jozefcipa/laundry-alert/assets/app-error.png

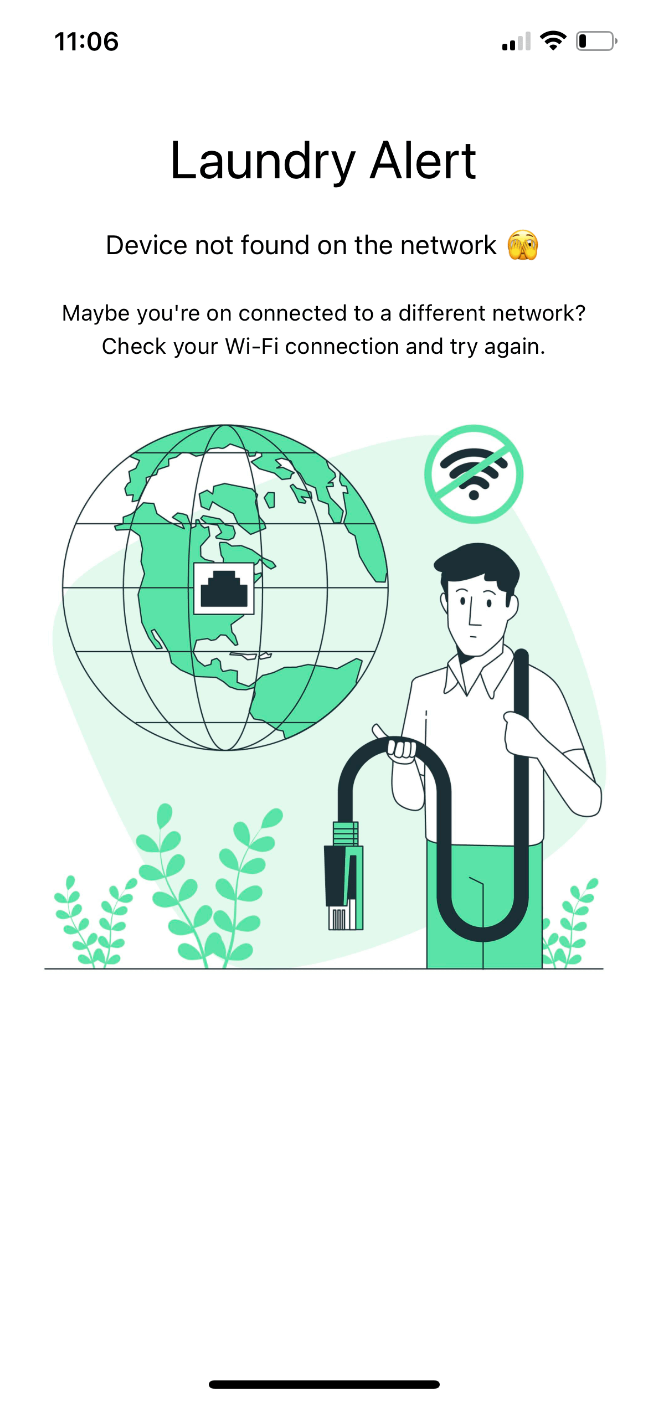
assets/app-error.png
