jozefcipa/laundry-alert/assets/app-loading.png

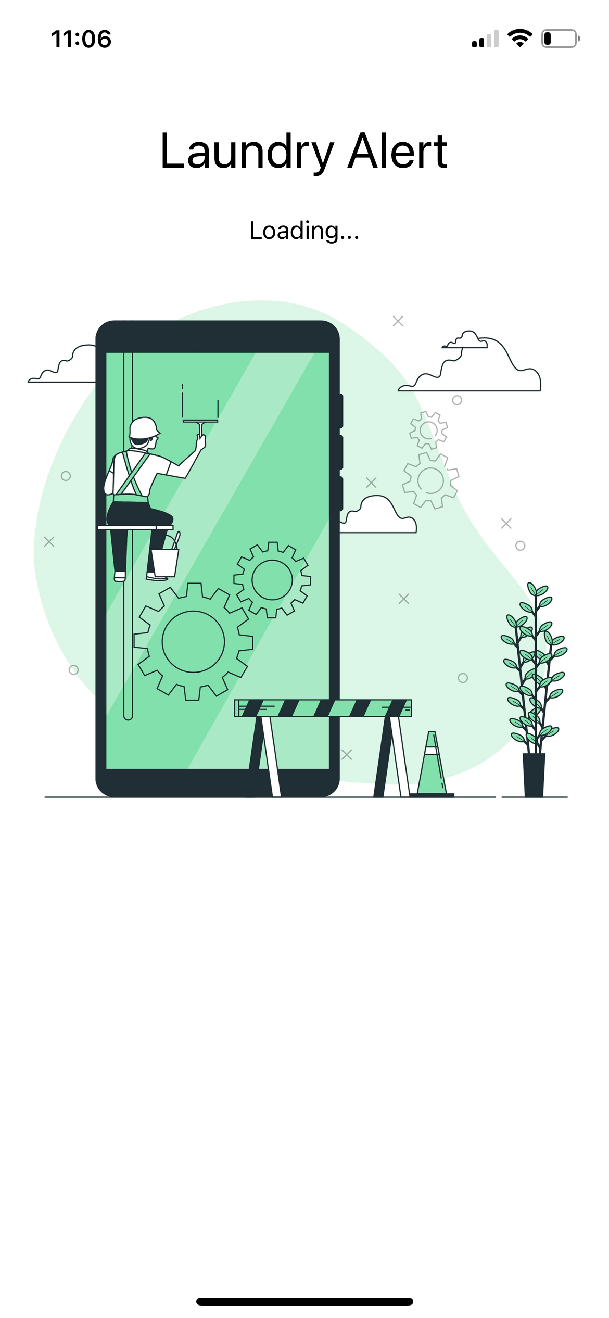
assets/app-loading.png
