jozefcipa/laundry-alert/assets/app-notification.png

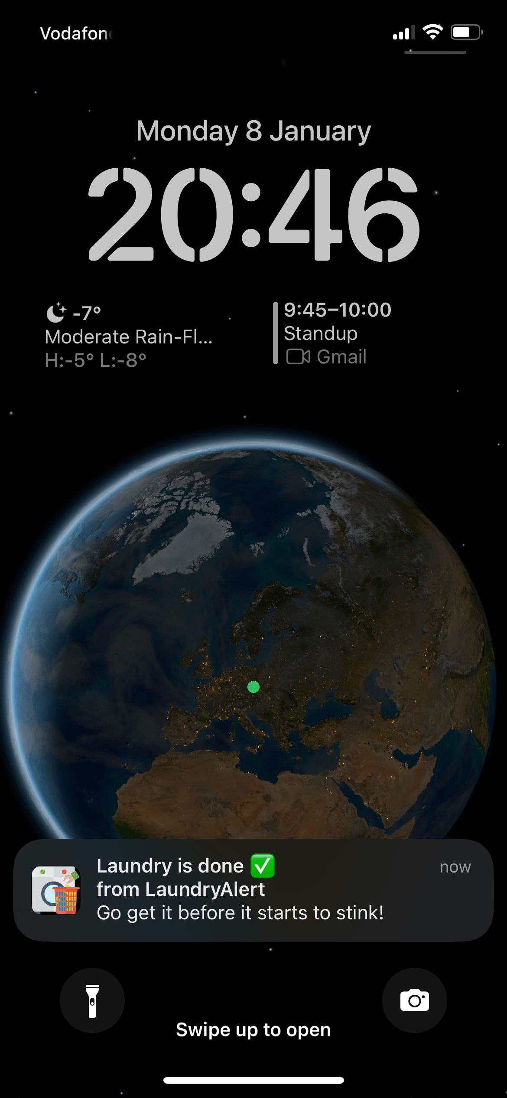
assets/app-notification.png
