jozefcipa/laundry-alert/assets/app-washing-done.png

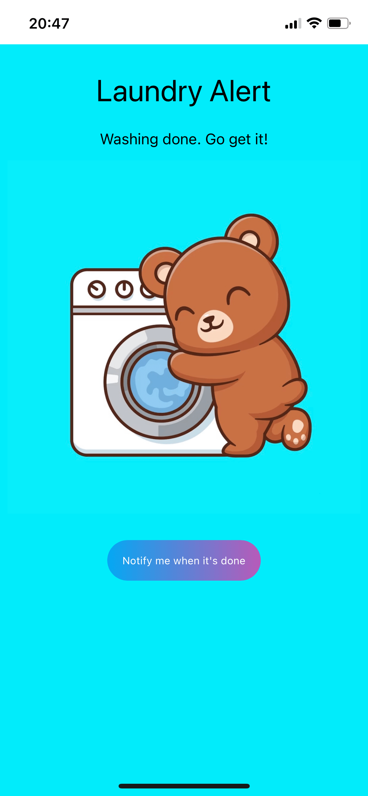
assets/app-washing-done.png
