jozefcipa/laundry-alert/assets/app-washing.png

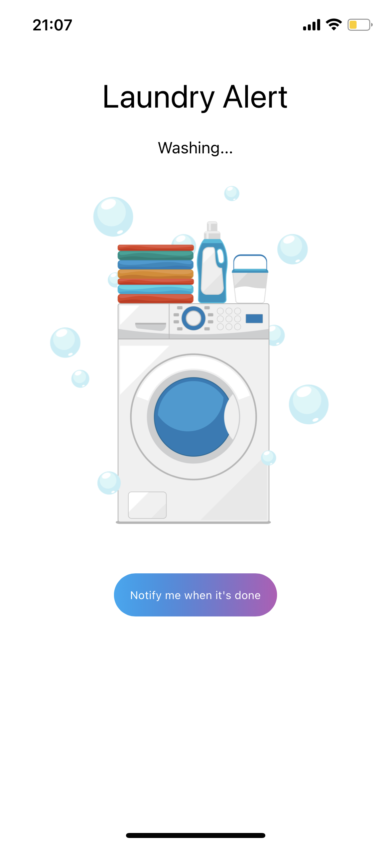
assets/app-washing.png
