jozefcipa/laundry-alert/assets/case.jpeg

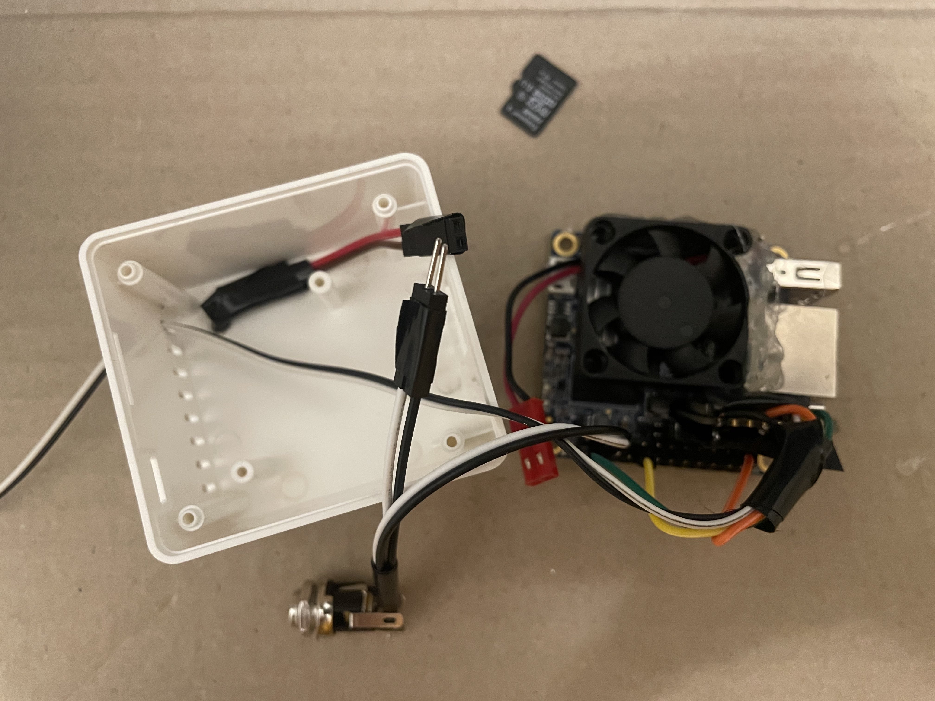
assets/case.jpeg
