jozefcipa/laundry-alert/assets/in-progres.jpeg

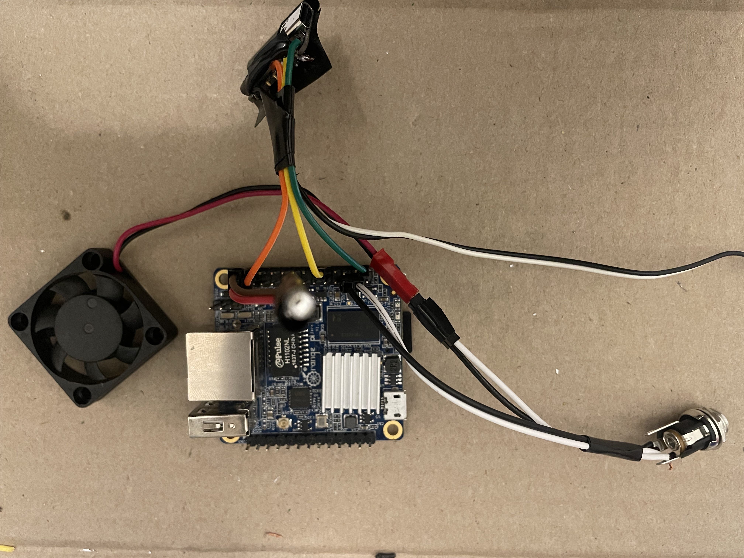
assets/in-progres.jpeg
