jozefcipa/laundry-alert/assets/laundry-alert.jpeg

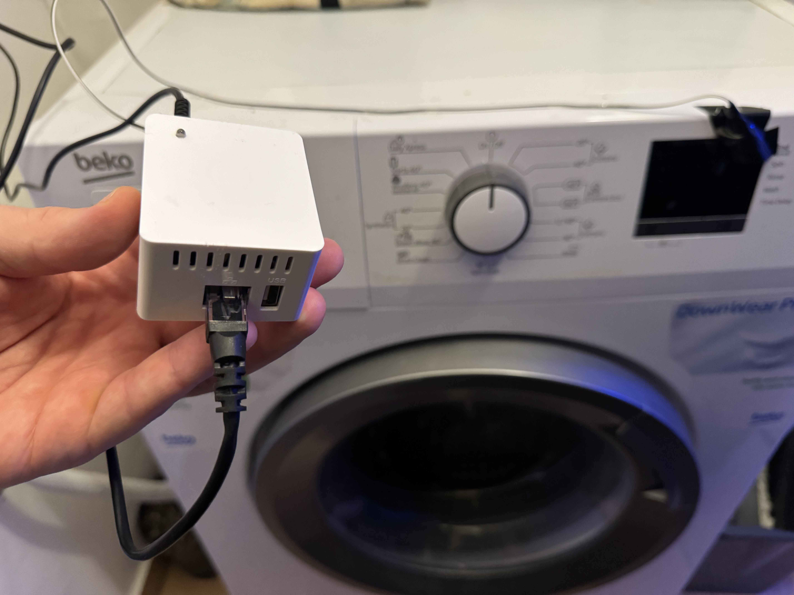
assets/laundry-alert.jpeg
