jozefcipa/laundry-alert/assets/debugging.jpeg

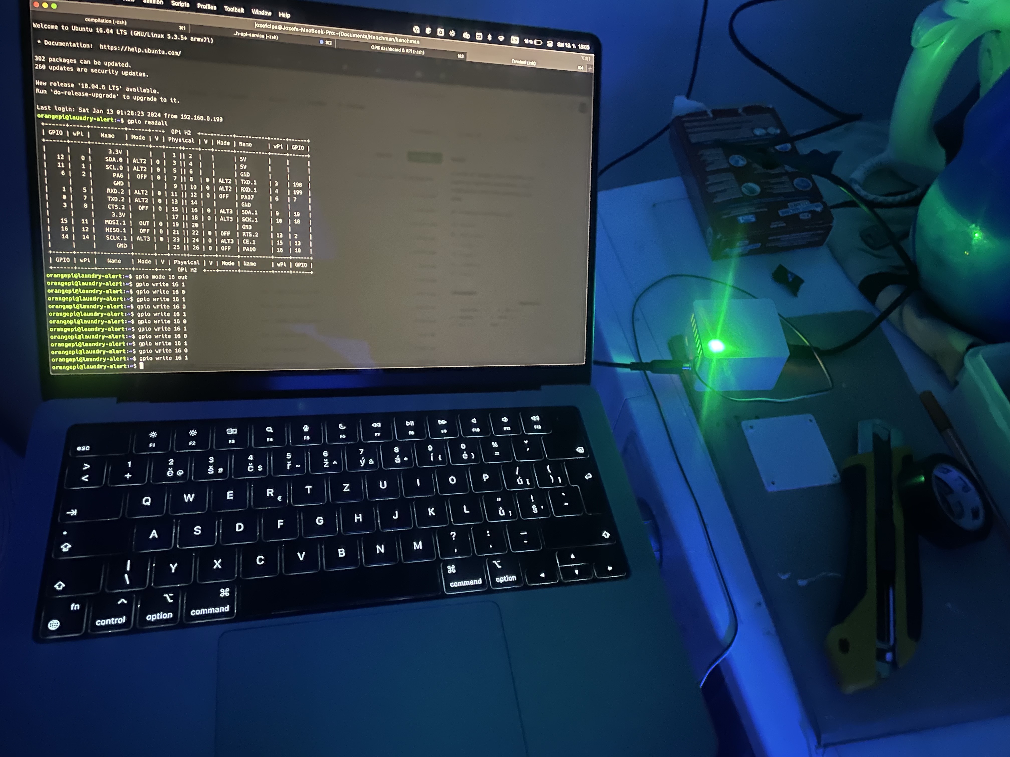
assets/debugging.jpeg
