jozefcipa/laundry-alert/(commit log)

2023-07-20 feat: add gpio wrapper, led blinking, other improvements
2023-08-09 fix: minor bug fixes
    [gpio.js, index.js]
2024-01-20 feat(led): slow down interval to 2s
2025-07-29 feat: add cpu temperature to status and update led pin
2025-08-05 fix: increase threshold for photoresistor
    [main.ino]
